rataflo/photocabine/doc/build log/IMG_20191106_195408.jpg

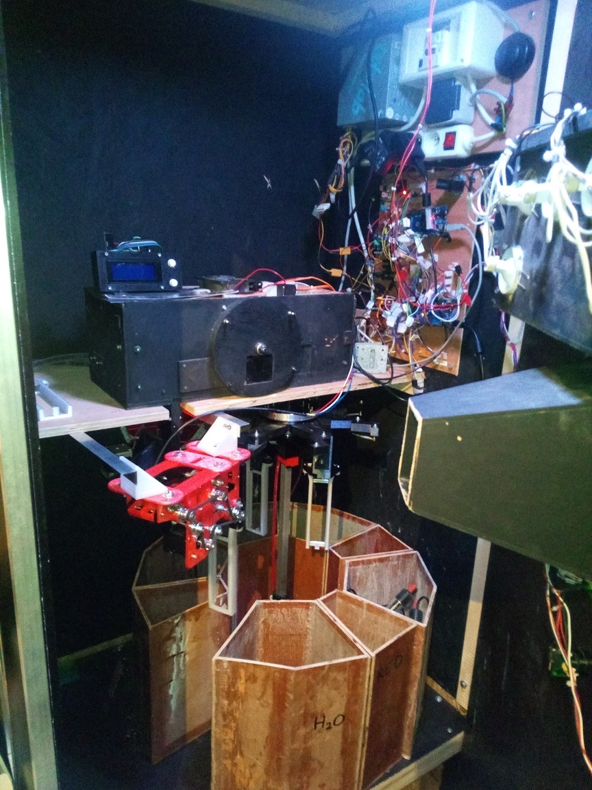
doc/build log/IMG_20191106_195408.jpg
