rataflo/photocabine/doc/Chemical_suppliers_usa.txt

Potassium dichromate : https://www.amazon.com/gp/offer-listing/B000B73OBO/ref=dp_olp_0?ie=UTF8&condition=all&qid=1568665300&sr=8-6
