rataflo/photocabine/hardware/easyeda_old/BOM_No_filter_booth_20200206081747.csv

ID | Name | Designator | Footprint | Quantity | Manufacturer Part | Manufacturer | Supplier | Supplier Part | Link | Price (USD)
1 | test2 | TEST |  | 1
2 | CYTRON MD10C | U-DRIVER_DC_ROTATION | MD10C | 1 | Cytron 13A, 5-30V Single DC Motor Controller |  |  | undefined
 |  |  | Total MD10C | 1
3 | led | LED_PAP2,LED_PAP3,LED__MIDDLE,LED_PAP4,LED_PAP1,LED__START,LED3_SHUTTER,LED_BOTTOM,LED,LED_ROT2,LED_UP,LED2_SCISSOR | 5MM_LED_2.54 | 12 | 5MMGREENLED |  | AliExpress |  | https://www.aliexpress.com/item/100Pcs-LED-5MM-RED-COLOR-RED-LIGHT-Super-Bright-Bulb-Lamp/32224565677.html | 0.01
 |  |  | Total 5MM_LED_2.54 | 12
4 | EXT_DIGITAL_CAMERA | EXT_DIGITAL_CAMERA | 1*10P_FEMALE | 1
 |  |  | Total 1*10P_FEMALE | 1
5 | ROT2 | SW_ROT2 | CONN-TH_3P-P2.00_KF2510_3A | 1 | kf2510_3A | BOOMELE | LCSC | C29275
6 | PAPER4 | SW_PAP4 | CONN-TH_3P-P2.00_KF2510_3A | 1 | kf2510_3A | BOOMELE | LCSC | C29275
7 | TEMP | BATH_TEMP | CONN-TH_3P-P2.00_KF2510_3A | 1 | kf2510_3A | BOOMELE | LCSC | C29275
8 | CEILING | CEILING | CONN-TH_3P-P2.00_KF2510_3A | 1 | kf2510_3A | BOOMELE | LCSC | C29275
9 | PAPER2 | SW_PAP2 | CONN-TH_3P-P2.00_KF2510_3A | 1 | kf2510_3A | BOOMELE | LCSC | C29275
10 | MARQUEE | MARQUEE | CONN-TH_3P-P2.00_KF2510_3A | 1 | kf2510_3A | BOOMELE | LCSC | C29275
11 | PAPER1 | SW_PAP1 | CONN-TH_3P-P2.00_KF2510_3A | 1 | kf2510_3A | BOOMELE | LCSC | C29275
12 | ROT1 | SW_ROT1 | CONN-TH_3P-P2.00_KF2510_3A | 1 | kf2510_3A | BOOMELE | LCSC | C29275
13 | PAPER3 | SW_PAP3 | CONN-TH_3P-P2.00_KF2510_3A | 1 | kf2510_3A | BOOMELE | LCSC | C29275
14 | SERVO | SERVO | CONN-TH_3P-P2.00_KF2510_3A | 1 | kf2510_3A | BOOMELE | LCSC | C29275
15 | LIGHT | PROCESS_LIGHT | CONN-TH_3P-P2.00_KF2510_3A | 1 | kf2510_3A | BOOMELE | LCSC | C29275
 |  |  | Total CONN-TH_3P-P2.00_KF2510_3A | 11
16 | RTC | RTC-DS3231-CONNECTOR | 5PIN DUPONT | 1
 |  |  | Total 5PIN DUPONT | 1
17 | ALIM_5V | ALIM_5V | D24V50F5 | 1
 |  |  | Total D24V50F5 | 1
18 | AUX | XT60_AUX | XT60 | 1
19 | FLASH | XT60-FLASH | XT60 | 1
20 | POWER_IN_12V | XT1_POWER_IN | XT60 | 1
 |  |  | Total XT60 | 3
21 | 100uF | 100UF_AUX,100UF_PROCESS_LIGHT,100UF_SERVO,C1_100UF_PAPER,C2_100UF_SHUTTER,C3_100UF_SCISSOR,C4_100UF_ROT,C5_100UF_EXIT | CPOL-RADIAL-100UF-25V | 8
22 | 100UF | 100UF_STARTBTN,100UF_FLASH,100UF_CEILING,100UF_MARQUEE | CPOL-RADIAL-100UF-25V | 4
 |  |  | Total CPOL-RADIAL-100UF-25V | 12
23 | UP | KF2_ENDSTOP_UP | CONN-TH_KF2510-2A | 1 | KF2510-2A | BOOMELE | LCSC | C27543
24 | DC_MOTOR | DC_MOTOR | CONN-TH_KF2510-2A | 1 | KF2510-2A | BOOMELE | LCSC | C27543
25 | BATT_PROBE | BATT_PROBE | CONN-TH_KF2510-2A | 1 | KF2510-2A | BOOMELE | LCSC | C27543
26 | SCISSOR | SW_SCISSOR | CONN-TH_KF2510-2A | 1 | KF2510-2A | BOOMELE | LCSC | C27543
27 | MIDDLE | KF2_ENDSTOP_MIDDLE | CONN-TH_KF2510-2A | 1 | KF2510-2A | BOOMELE | LCSC | C27543
28 | BOTTOM | KF2_ENDSTOP_DOWN | CONN-TH_KF2510-2A | 1 | KF2510-2A | BOOMELE | LCSC | C27543
29 | SHUTTER | SW_SHUTTER | CONN-TH_KF2510-2A | 1 | KF2510-2A | BOOMELE | LCSC | C27543
 |  |  | Total CONN-TH_KF2510-2A | 7
30 | 2.2K | R2_FLASH,R1_STARTBTN,R3_AUX | RES-2.3 | 3 | FHCFR-1/4W-222J |  | SeeedStudio | 301020010
 |  |  | Total RES-2.3 | 3
31 | TIP120 | TIP120_STARTBTN,TIP120_AUX | TO-220-3_L10.0-W4.5-P2.54-L | 2 | TIP120 | STMicroelectronics | LCSC | C262990
 |  |  | Total TO-220-3_L10.0-W4.5-P2.54-L | 2
32 | CAMERA | U1-CAMERA | MEGA2560 PRO-CH340G | 1 | MEGA2560 PRO-ch340G | RobotDyn | RobotDyn | MEGA2560 PRO-ch340G
33 | PAPER_PROCESS | U2-PAPER_PROCESS | MEGA2560 PRO-CH340G | 1 | MEGA2560 PRO-ch340G | RobotDyn | RobotDyn | MEGA2560 PRO-ch340G
 |  |  | Total MEGA2560 PRO-CH340G | 2
34 | SCISSOR | DRV_SCISSOR | POLOLU_BREAKOUT-16_15.2X20.3MM | 1
35 | ROTATION | DRV_ROT | POLOLU_BREAKOUT-16_15.2X20.3MM | 1 |  | Pololu
36 | PAPER | DRV_PAPER | POLOLU_BREAKOUT-16_15.2X20.3MM | 1 |  | Pololu
37 | SHUTTER | DRV_SHUTTER | POLOLU_BREAKOUT-16_15.2X20.3MM | 1
38 | EXIT | DRV_EXIT | POLOLU_BREAKOUT-16_15.2X20.3MM | 1 |  | Pololu
 |  |  | Total POLOLU_BREAKOUT-16_15.2X20.3MM | 5
39 | ANALOG_CAMERA | EXT_ANALOG_CAMERA | DUPONT_MALE_16X1_ARNOZ | 1 | 1.27mm1*10P Straight Headers Pins | ReliaPro | LCSC | C28952
40 | DIGITAL_PAPER | EXT_DIGITAL_PAPER | DUPONT_MALE_16X1_ARNOZ | 1 | 1.27mm1*10P Straight Headers Pins | ReliaPro | LCSC | C28952
41 | ANALOG_PAPER | EXT_ANALOG_PAPER | DUPONT_MALE_16X1_ARNOZ | 1 | 1.27mm1*10P Straight Headers Pins | ReliaPro | LCSC | C28952
 |  |  | Total DUPONT_MALE_16X1_ARNOZ | 3
42 | 20k | R1_20K_12VBATT | PKG-0.25W RESISTOR | 1 | CFR16J15K | MULTICOMP | Element14 | 2329483
43 | 10k | R2_10K_12VBATT | PKG-0.25W RESISTOR | 1 | CFR16J15K | MULTICOMP | Element14 | 2329483
 |  |  | Total PKG-0.25W RESISTOR | 2
44 | NRF24 | NRF24L01 | HEADER 4X2 | 1 | Custom
 |  |  | Total HEADER 4X2 | 1
45 | MATRIX | LEDMATRIX | KF2510-5A | 1 | KF2510-5A | ReliaPro | LCSC | C27544
 |  |  | Total KF2510-5A | 1
46 | RT-S01-145-L1NB1B | SW1 | SW-TH_RT-S01-145-L1NB1B | 1 | RT-S01-145-L1NB1B | ROCKTEK | LCSC | C312627
 |  |  | Total SW-TH_RT-S01-145-L1NB1B | 1
47 | ROTATION | KF2510-4A_ROT | CONN-TH_4P-P2.54_KF2510-4A | 1 | KF2510-4A | ReliaPro | LCSC | C27542
48 | SHUTTER | KF4_2_STEP_SHUTTER | CONN-TH_4P-P2.54_KF2510-4A | 1 | KF2510-4A | ReliaPro | LCSC | C27542
49 | KF2510-4A | EXIT | CONN-TH_4P-P2.54_KF2510-4A | 1 | KF2510-4A | ReliaPro | LCSC | C27542
50 | START | KF2510-4A-START_BTN | CONN-TH_4P-P2.54_KF2510-4A | 1 | KF2510-4A | ReliaPro | LCSC | C27542
51 | SEGMENT | SEGMENT | CONN-TH_4P-P2.54_KF2510-4A | 1 | KF2510-4A | ReliaPro | LCSC | C27542
52 | LUX_SENSOR | LUX_SENSOR | CONN-TH_4P-P2.54_KF2510-4A | 1 | KF2510-4A | ReliaPro | LCSC | C27542
53 | COIN | COIN | CONN-TH_4P-P2.54_KF2510-4A | 1 | KF2510-4A | ReliaPro | LCSC | C27542
54 | PAPER | KF4_3_STEP_PAPER | CONN-TH_4P-P2.54_KF2510-4A | 1 | KF2510-4A | ReliaPro | LCSC | C27542
55 | SCISSOR | STEP_SCISSOR | CONN-TH_4P-P2.54_KF2510-4A | 1 | KF2510-4A | ReliaPro | LCSC | C27542
 |  |  | Total CONN-TH_4P-P2.54_KF2510-4A | 9
56 | 150ohm | R1_UP,R5_SHUTTER,R3_MIDDLE,R_ROT1,R_PAP2,R2_BOTTOM,R_PAP3,R_ROT2,R_PAP4,R1_START,R_PAP1,R4_SCISSOR | ER_RESISTOR_150R/0.6_W | 12 |  |  |  | undefined
 |  |  | Total ER_RESISTOR_150R/0.6_W | 12
57 | 0.1uF | 100UF_MEGA_CAMERA,01UF_MEGA_PAPER,01UF_RTC,01UF_COIN,01UF_SEGMENT,01UF_MATRIX,01UF_MARQUEE | 100NF_CONDO | 7 | 0.1uF(104) 100V | ReliaPro | LCSC | undefined
 |  |  | Total 100NF_CONDO | 7
58 | BDX53B | BDX53B_FLASH | TO-220 | 1
 |  |  | Total TO-220 | 1
 |  |  | Total général | 99
