rataflo/photocabine/svg/lasercut1_bis.dxf

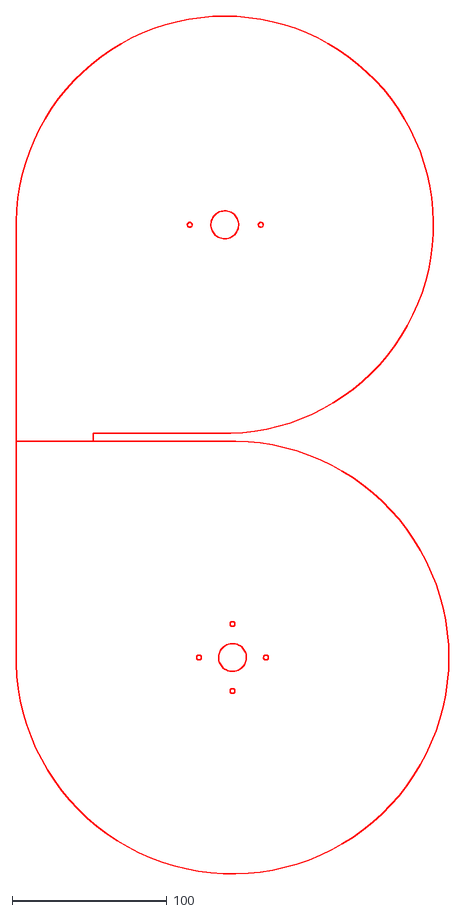
[picture p2: CAD file, 2020-11-24]
svg/lasercut1_bis.dxf
279.9 x 554.9
