rataflo/photocabine/svg/lasercut2_bis.dxf

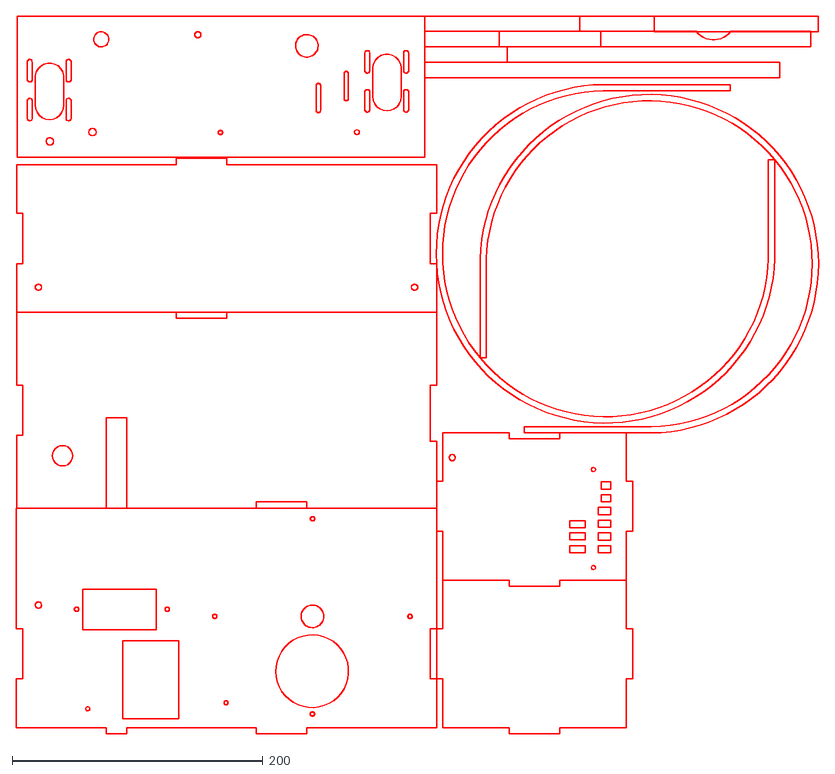
[picture p3: CAD file, 2020-11-24]
svg/lasercut2_bis.dxf
639.6 x 572.5
