rataflo/photocabine/svg/lasercut2.dxf

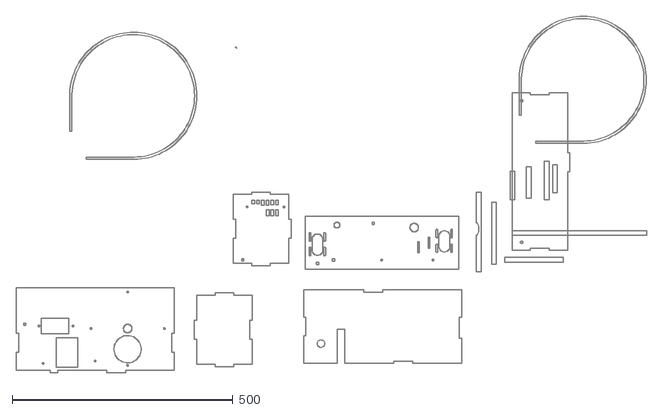
[picture p4: CAD file, 2020-11-24]
svg/lasercut2.dxf
1425.9 x 806.8
