rataflo/photocabine/(list of files, cad)

Other CAD files:
3dprint/dc_motor_support_xd-3420.skp
3dprint/paper_support_spider.skp
3dprint/support_6000Z.skp
