rataflo/photocabine/(list of files, drawings)

Other design files:
hardware/easyeda_old/1-PCB_PCB_2020-01-23 22_02_10.json
hardware/easyeda_old/1-Schematic_No filter booth pcb.json
hardware/easyeda_old/Schematic.schdoc
hardware/easyeda_old/SchematicV2.schdoc
hardware/kicad/nofilterbooth.dsn
