rataflo/photocabine/hardware/kicad/nofilterbooth.kicad_pcb

## KiCad design hardware/kicad/nofilterbooth.kicad_pcb (2020-02-25)

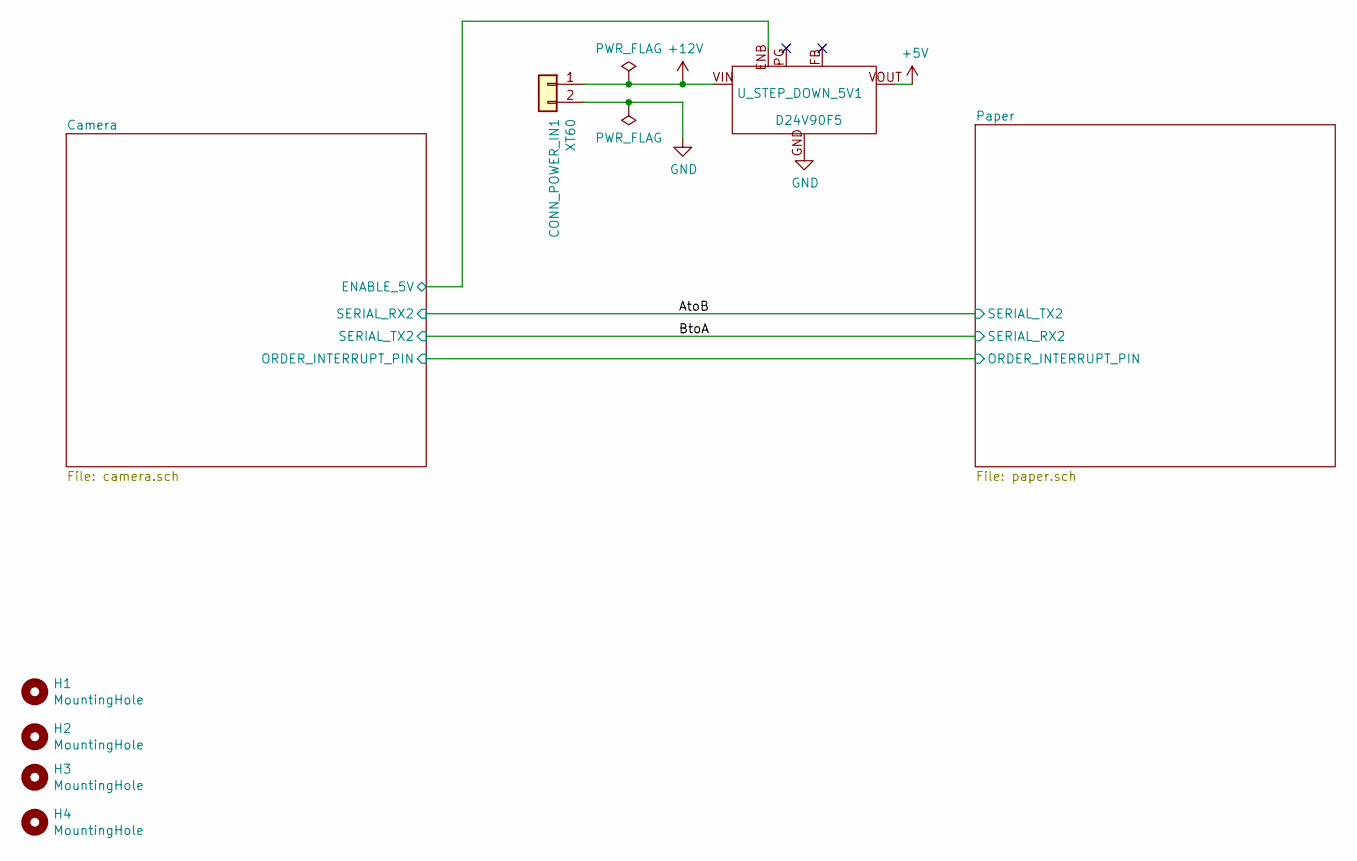
[picture p8: schematic nofilterbooth.sch]

Parts:
CONN_POWER_IN1: XT60; AMASS_XT60-F_1x02_P7.20mm_Vertical
H1, H2, H3, H4: MountingHole; MountingHole_3.2mm_M3
U_STEP_DOWN_5V1: D24V90F5

Connections:
+5V: U_STEP_DOWN_5V1.VOUT; also elsewhere on the board
+12V: CONN_POWER_IN1.1, U_STEP_DOWN_5V1.VIN; also elsewhere on the board
/Camera/ENABLE_5V: U_STEP_DOWN_5V1.ENB; also elsewhere on the board
GND: CONN_POWER_IN1.2, U_STEP_DOWN_5V1.GND; also elsewhere on the board

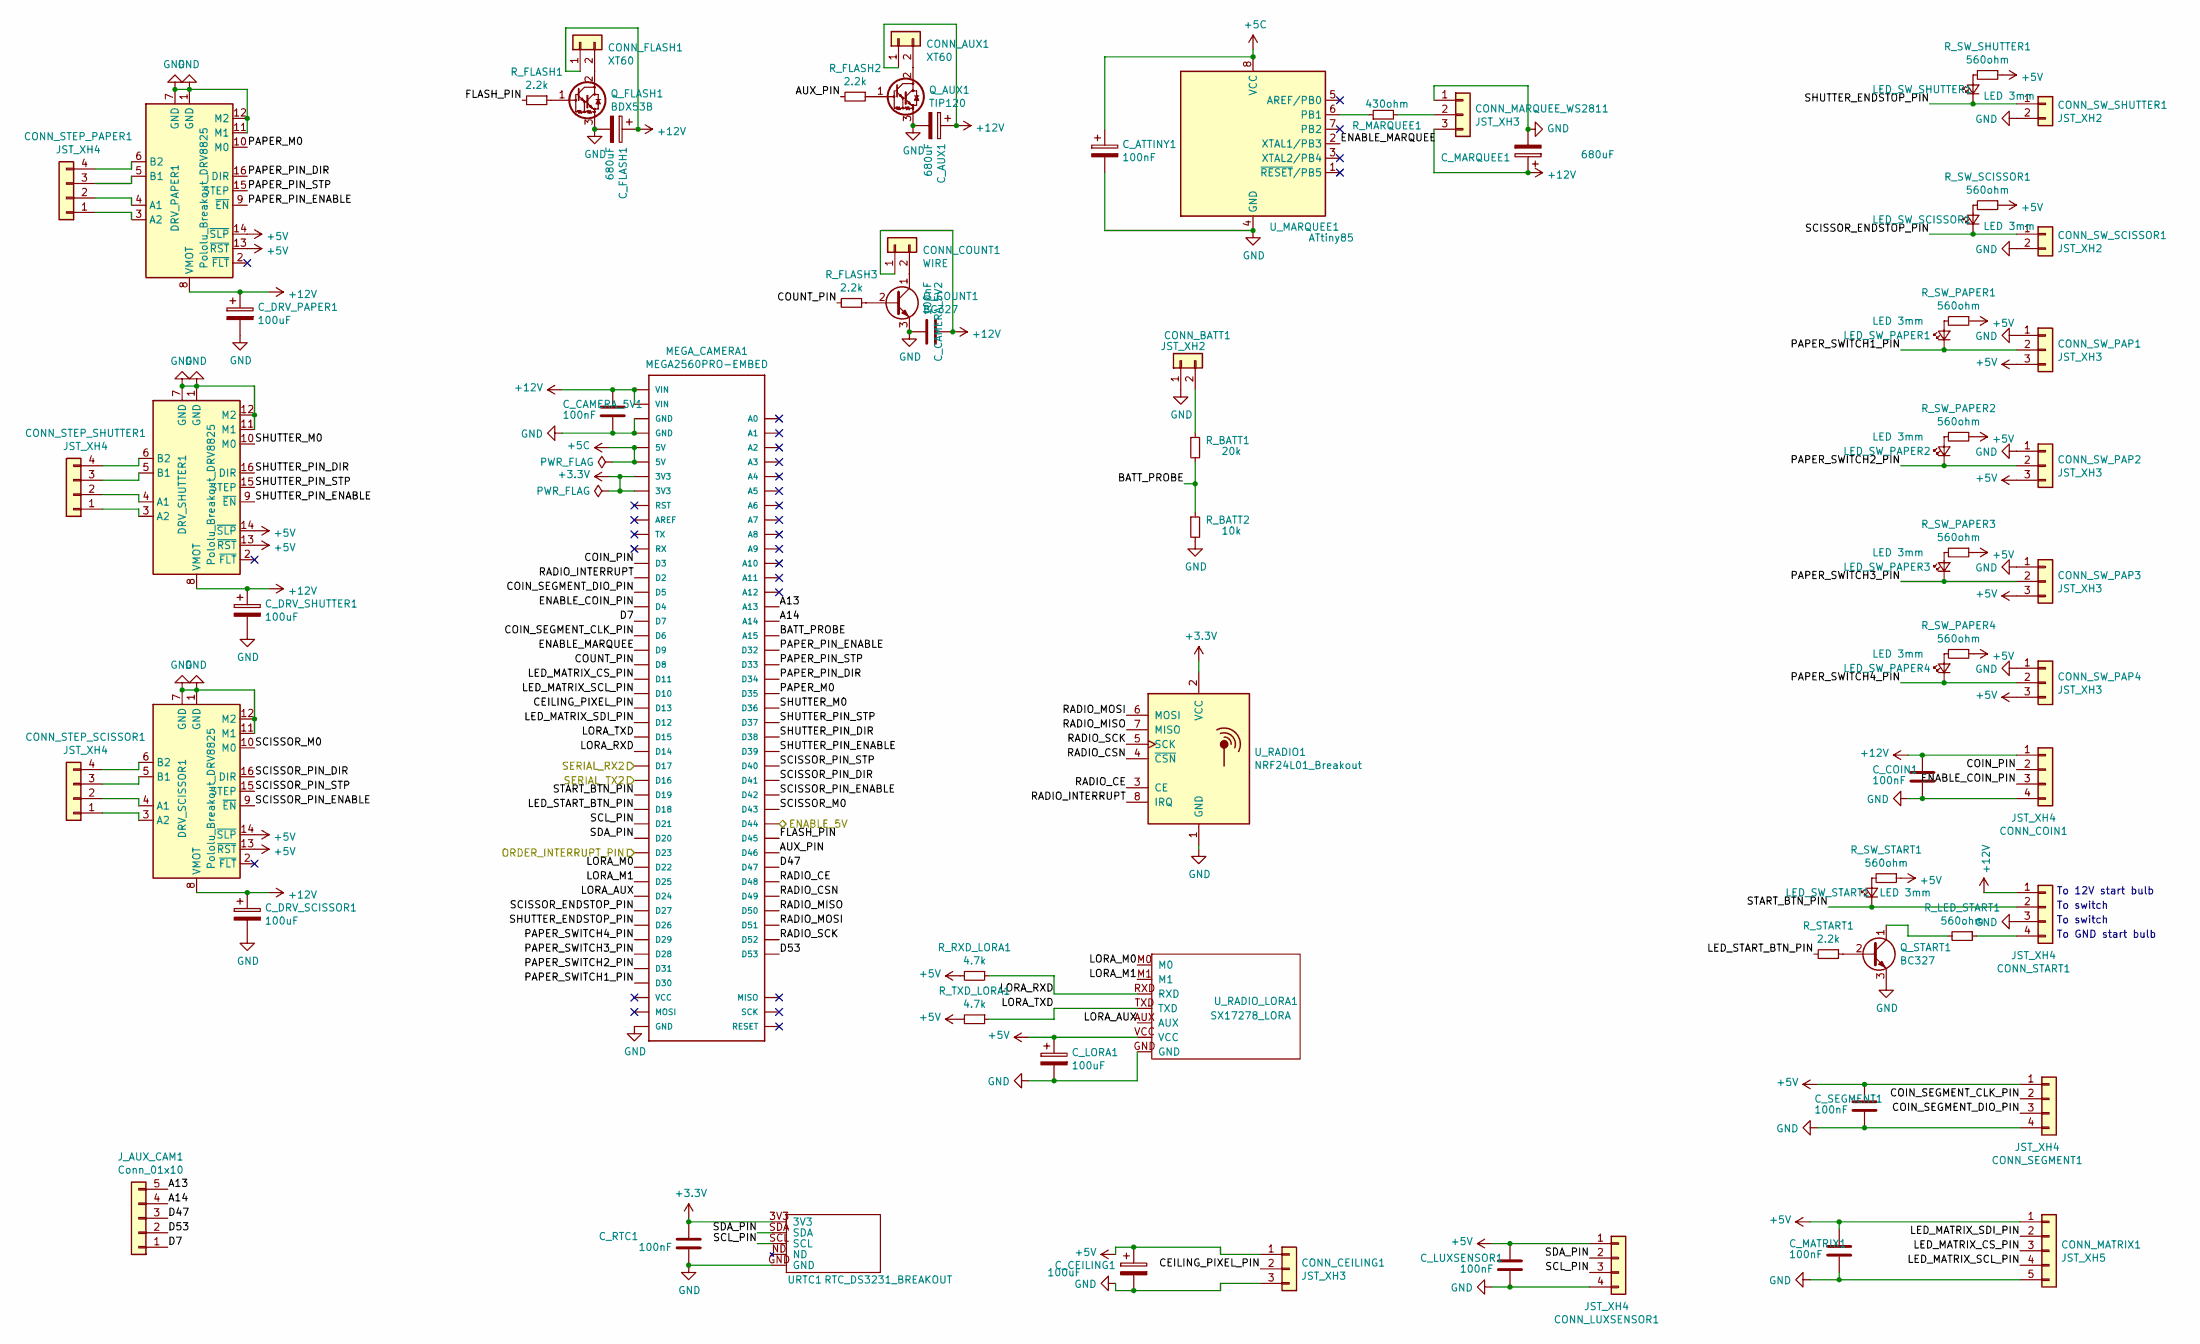
[picture p9: schematic camera.sch]

Parts:
CONN_AUX1: XT60; AMASS_XT60-F_1x02_P7.20mm_Vertical
CONN_BATT1: JST_XH2; JST_XH_S2B-XH-A-1_1x02_P2.50mm_Horizontal
CONN_CEILING1: JST_XH3; JST_XH_S3B-XH-A-1_1x03_P2.50mm_Horizontal
CONN_COIN1: JST_XH4; JST_XH_S4B-XH-A-1_1x04_P2.50mm_Horizontal
CONN_COUNT1: WIRE; PinHeader_1x02_P2.54mm_Vertical
CONN_FLASH1: XT60; AMASS_XT60-F_1x02_P7.20mm_Vertical
CONN_LUXSENSOR1: JST_XH4; JST_XH_S4B-XH-A-1_1x04_P2.50mm_Horizontal
CONN_MARQUEE_WS2811: JST_XH3; JST_XH_S3B-XH-A-1_1x03_P2.50mm_Horizontal
CONN_MATRIX1: JST_XH5; JST_XH_S5B-XH-A-1_1x05_P2.50mm_Horizontal
CONN_SEGMENT1: JST_XH4; JST_XH_S4B-XH-A-1_1x04_P2.50mm_Horizontal
CONN_START1: JST_XH4; JST_XH_S4B-XH-A-1_1x04_P2.50mm_Horizontal
CONN_STEP_PAPER1: JST_XH4; JST_XH_S4B-XH-A-1_1x04_P2.50mm_Horizontal
CONN_STEP_SCISSOR1: JST_XH4; JST_XH_S4B-XH-A-1_1x04_P2.50mm_Horizontal
CONN_STEP_SHUTTER1: JST_XH4; JST_XH_S4B-XH-A-1_1x04_P2.50mm_Horizontal
CONN_SW_PAP1, CONN_SW_PAP2, CONN_SW_PAP3, CONN_SW_PAP4: JST_XH3; JST_XH_S3B-XH-A-1_1x03_P2.50mm_Horizontal
CONN_SW_SCISSOR1: JST_XH2; JST_XH_S2B-XH-A-1_1x02_P2.50mm_Horizontal
CONN_SW_SHUTTER1: JST_XH2; JST_XH_S2B-XH-A-1_1x02_P2.50mm_Horizontal
C_ATTINY1: 100nF; C_Rect_L7.2mm_W2.5mm_P5.00mm_FKS2_FKP2_MKS2_MKP2
C_AUX1: 680uF; CP_Radial_D8.0mm_P3.50mm
C_CAMERA_5V1, C_CAMERA_5V2: 100nF; C_Rect_L7.2mm_W2.5mm_P5.00mm_FKS2_FKP2_MKS2_MKP2
C_CEILING1: 100uF; CP_Radial_D6.3mm_P2.50mm
C_COIN1: 100nF; C_Rect_L7.2mm_W2.5mm_P5.00mm_FKS2_FKP2_MKS2_MKP2
C_DRV_PAPER1: 100uF; CP_Radial_D6.3mm_P2.50mm
C_DRV_SCISSOR1: 100uF; CP_Radial_D6.3mm_P2.50mm
C_DRV_SHUTTER1: 100uF; CP_Radial_D6.3mm_P2.50mm
C_FLASH1: 680uF; CP_Radial_D8.0mm_P3.50mm
C_LORA1: 100uF; CP_Radial_D6.3mm_P2.50mm
C_LUXSENSOR1: 100nF; C_Rect_L7.2mm_W2.5mm_P5.00mm_FKS2_FKP2_MKS2_MKP2
C_MARQUEE1: 680uF; CP_Radial_D8.0mm_P3.50mm
C_MATRIX1: 100nF; C_Rect_L7.2mm_W2.5mm_P5.00mm_FKS2_FKP2_MKS2_MKP2
C_RTC1: 100nF; C_Rect_L7.2mm_W2.5mm_P5.00mm_FKS2_FKP2_MKS2_MKP2
C_SEGMENT1: 100nF; C_Rect_L7.2mm_W2.5mm_P5.00mm_FKS2_FKP2_MKS2_MKP2
DRV_PAPER1: Pololu_Breakout_DRV8825; Pololu_Breakout-16_15.2x20.3mm
DRV_SCISSOR1: Pololu_Breakout_DRV8825; Pololu_Breakout-16_15.2x20.3mm
DRV_SHUTTER1: Pololu_Breakout_DRV8825; Pololu_Breakout-16_15.2x20.3mm
J_AUX_CAM1: Conn_01x10; PinHeader_1x05_P2.54mm_Vertical
LED_SW_PAPER1, LED_SW_PAPER2, LED_SW_PAPER3, LED_SW_PAPER4: LED 3mm; LED_D3.0mm
LED_SW_SCISSOR1: LED 3mm; LED_D3.0mm
LED_SW_SHUTTER1: LED 3mm; LED_D3.0mm
LED_SW_START1: LED 3mm; LED_D3.0mm
MEGA_CAMERA1: MEGA2560PRO-EMBED
Q_AUX1: TIP120; TO-220-3_Vertical
Q_COUNT1: BC327; TO-92L_HandSolder
Q_FLASH1: BDX53B; TO-220-3_Vertical
Q_START1: BC327; TO-92L_HandSolder
R_BATT1: 20k; R_Axial_DIN0207_L6.3mm_D2.5mm_P10.16mm_Horizontal
R_BATT2: 10k; R_Axial_DIN0207_L6.3mm_D2.5mm_P10.16mm_Horizontal
R_FLASH1, R_FLASH2, R_FLASH3: 2.2k; R_Axial_DIN0207_L6.3mm_D2.5mm_P10.16mm_Horizontal
R_LED_START1: 560ohm; R_Axial_DIN0207_L6.3mm_D2.5mm_P10.16mm_Horizontal
R_MARQUEE1: 430ohm; R_Axial_DIN0207_L6.3mm_D2.5mm_P10.16mm_Horizontal
R_RXD_LORA1: 4.7k; R_Axial_DIN0207_L6.3mm_D2.5mm_P10.16mm_Horizontal
R_START1: 2.2k; R_Axial_DIN0207_L6.3mm_D2.5mm_P10.16mm_Horizontal
R_SW_PAPER1, R_SW_PAPER2, R_SW_PAPER3, R_SW_PAPER4: 560ohm; R_Axial_DIN0207_L6.3mm_D2.5mm_P10.16mm_Horizontal
R_SW_SCISSOR1: 560ohm; R_Axial_DIN0207_L6.3mm_D2.5mm_P10.16mm_Horizontal
R_SW_SHUTTER1: 560ohm; R_Axial_DIN0207_L6.3mm_D2.5mm_P10.16mm_Horizontal
R_SW_START1: 560ohm; R_Axial_DIN0207_L6.3mm_D2.5mm_P10.16mm_Horizontal
R_TXD_LORA1: 4.7k; R_Axial_DIN0207_L6.3mm_D2.5mm_P10.16mm_Horizontal
URTC1: RTC_DS3231_BREAKOUT; DS3231_breakout
U_MARQUEE1: ATtiny85; DIP-8_W7.62mm
U_RADIO1: NRF24L01_Breakout; nRF24L01_Breakout
U_RADIO_LORA1: SX17278_LORA; LORA_E32-TTL-100

Connections:
+3V3: C_RTC1.1, MEGA_CAMERA1.3V3, URTC1.3V3, U_RADIO1.2 (VCC)
+5C: C_ATTINY1.1, MEGA_CAMERA1.5V, U_MARQUEE1.8 (VCC)
+5V: CONN_CEILING1.1, CONN_LUXSENSOR1.1, CONN_MATRIX1.1, CONN_SEGMENT1.1, CONN_SW_PAP1.3, CONN_SW_PAP2.3, CONN_SW_PAP3.3, CONN_SW_PAP4.3, C_CEILING1.1, C_LORA1.1, C_LUXSENSOR1.1, C_MATRIX1.1, C_SEGMENT1.1, DRV_PAPER1.13 (~RST), DRV_PAPER1.14 (~SLP), DRV_SCISSOR1.13 (~RST), DRV_SCISSOR1.14 (~SLP), DRV_SHUTTER1.13 (~RST), DRV_SHUTTER1.14 (~SLP), R_RXD_LORA1.2, R_SW_PAPER1.1, R_SW_PAPER2.1, R_SW_PAPER3.1, R_SW_PAPER4.1, R_SW_SCISSOR1.1, R_SW_SHUTTER1.1, R_SW_START1.1, R_TXD_LORA1.2, U_RADIO_LORA1.VCC; also elsewhere on the board
+12V: CONN_AUX1.1, CONN_COIN1.1, CONN_COUNT1.1, CONN_FLASH1.1, CONN_MARQUEE_WS2811.3, CONN_START1.1, C_AUX1.1, C_CAMERA_5V1.1, C_CAMERA_5V2.1, C_COIN1.1, C_DRV_PAPER1.1, C_DRV_SCISSOR1.1, C_DRV_SHUTTER1.1, C_FLASH1.1, C_MARQUEE1.1, DRV_PAPER1.8 (VMOT), DRV_SCISSOR1.8 (VMOT), DRV_SHUTTER1.8 (VMOT), MEGA_CAMERA1.VIN; also elsewhere on the board
/AtoB: MEGA_CAMERA1.D17; also elsewhere on the board
/BtoA: MEGA_CAMERA1.D16; also elsewhere on the board
/Camera/A13: J_AUX_CAM1.5, MEGA_CAMERA1.A13
/Camera/A14: J_AUX_CAM1.4, MEGA_CAMERA1.A14
/Camera/AUX_PIN: MEGA_CAMERA1.D46, R_FLASH2.2
/Camera/BATT_PROBE: MEGA_CAMERA1.A15, R_BATT1.2, R_BATT2.1
/Camera/CEILING_PIXEL_PIN: CONN_CEILING1.2, MEGA_CAMERA1.D13
/Camera/COIN_PIN: CONN_COIN1.2, MEGA_CAMERA1.D3
/Camera/COIN_SEGMENT_CLK_PIN: CONN_SEGMENT1.2, MEGA_CAMERA1.D6
/Camera/COIN_SEGMENT_DIO_PIN: CONN_SEGMENT1.3, MEGA_CAMERA1.D5
/Camera/COUNT_PIN: MEGA_CAMERA1.D8, R_FLASH3.2
/Camera/D7: J_AUX_CAM1.1, MEGA_CAMERA1.D7
/Camera/D47: J_AUX_CAM1.3, MEGA_CAMERA1.D47
/Camera/D53: J_AUX_CAM1.2, MEGA_CAMERA1.D53
/Camera/ENABLE_5V: MEGA_CAMERA1.D44; also elsewhere on the board
/Camera/ENABLE_COIN_PIN: CONN_COIN1.3, MEGA_CAMERA1.D4
/Camera/ENABLE_MARQUEE: MEGA_CAMERA1.D9, U_MARQUEE1.2 (XTAL1/PB3)
/Camera/FLASH_PIN: MEGA_CAMERA1.D45, R_FLASH1.2
/Camera/LED_MATRIX_CS_PIN: CONN_MATRIX1.3, MEGA_CAMERA1.D11
/Camera/LED_MATRIX_SCL_PIN: CONN_MATRIX1.4, MEGA_CAMERA1.D10
/Camera/LED_MATRIX_SDI_PIN: CONN_MATRIX1.2, MEGA_CAMERA1.D12
/Camera/LED_START_BTN_PIN: MEGA_CAMERA1.D18, R_START1.2
/Camera/LORA_AUX: MEGA_CAMERA1.D24, U_RADIO_LORA1.AUX
/Camera/LORA_M0: MEGA_CAMERA1.D22, U_RADIO_LORA1.M0
/Camera/LORA_M1: MEGA_CAMERA1.D25, U_RADIO_LORA1.M1
/Camera/LORA_RXD: MEGA_CAMERA1.D14, R_RXD_LORA1.1, U_RADIO_LORA1.RXD
/Camera/LORA_TXD: MEGA_CAMERA1.D15, R_TXD_LORA1.1, U_RADIO_LORA1.TXD
/Camera/ORDER_INTERRUPT_PIN: MEGA_CAMERA1.D23; also elsewhere on the board
/Camera/PAPER_M0: DRV_PAPER1.10 (M0), MEGA_CAMERA1.D35
/Camera/PAPER_PIN_DIR: DRV_PAPER1.16 (DIR), MEGA_CAMERA1.D34
/Camera/PAPER_PIN_ENABLE: DRV_PAPER1.9 (~EN), MEGA_CAMERA1.D32
/Camera/PAPER_PIN_STP: DRV_PAPER1.15 (STEP), MEGA_CAMERA1.D33
/Camera/PAPER_SWITCH1_PIN: CONN_SW_PAP1.2, LED_SW_PAPER1.1 (K), MEGA_CAMERA1.D30
/Camera/PAPER_SWITCH2_PIN: CONN_SW_PAP2.2, LED_SW_PAPER2.1 (K), MEGA_CAMERA1.D31
/Camera/PAPER_SWITCH3_PIN: CONN_SW_PAP3.2, LED_SW_PAPER3.1 (K), MEGA_CAMERA1.D28
/Camera/PAPER_SWITCH4_PIN: CONN_SW_PAP4.2, LED_SW_PAPER4.1 (K), MEGA_CAMERA1.D29
/Camera/RADIO_CE: MEGA_CAMERA1.D48, U_RADIO1.3 (CE)
/Camera/RADIO_CSN: MEGA_CAMERA1.D49, U_RADIO1.4 (~CSN)
/Camera/RADIO_INTERRUPT: MEGA_CAMERA1.D2, U_RADIO1.8 (IRQ)
/Camera/RADIO_MISO: MEGA_CAMERA1.D50, U_RADIO1.7 (MISO)
/Camera/RADIO_MOSI: MEGA_CAMERA1.D51, U_RADIO1.6 (MOSI)
/Camera/RADIO_SCK: MEGA_CAMERA1.D52, U_RADIO1.5 (SCK)
/Camera/SCISSOR_ENDSTOP_PIN: CONN_SW_SCISSOR1.1, LED_SW_SCISSOR1.1 (K), MEGA_CAMERA1.D27
/Camera/SCISSOR_M0: DRV_SCISSOR1.10 (M0), MEGA_CAMERA1.D43
/Camera/SCISSOR_PIN_DIR: DRV_SCISSOR1.16 (DIR), MEGA_CAMERA1.D41
/Camera/SCISSOR_PIN_ENABLE: DRV_SCISSOR1.9 (~EN), MEGA_CAMERA1.D42
/Camera/SCISSOR_PIN_STP: DRV_SCISSOR1.15 (STEP), MEGA_CAMERA1.D40
/Camera/SCL_PIN: CONN_LUXSENSOR1.3, MEGA_CAMERA1.D21, URTC1.SCL
/Camera/SDA_PIN: CONN_LUXSENSOR1.2, MEGA_CAMERA1.D20, URTC1.SDA
/Camera/SHUTTER_ENDSTOP_PIN: CONN_SW_SHUTTER1.1, LED_SW_SHUTTER1.1 (K), MEGA_CAMERA1.D26
/Camera/SHUTTER_M0: DRV_SHUTTER1.10 (M0), MEGA_CAMERA1.D36
/Camera/SHUTTER_PIN_DIR: DRV_SHUTTER1.16 (DIR), MEGA_CAMERA1.D38
/Camera/SHUTTER_PIN_ENABLE: DRV_SHUTTER1.9 (~EN), MEGA_CAMERA1.D39
/Camera/SHUTTER_PIN_STP: DRV_SHUTTER1.15 (STEP), MEGA_CAMERA1.D37
/Camera/START_BTN_PIN: CONN_START1.2, LED_SW_START1.1 (K), MEGA_CAMERA1.D19
GND: CONN_BATT1.1, CONN_CEILING1.3, CONN_COIN1.4, CONN_LUXSENSOR1.4, CONN_MARQUEE_WS2811.1, CONN_MATRIX1.5, CONN_SEGMENT1.4, CONN_START1.3, CONN_SW_PAP1.1, CONN_SW_PAP2.1, CONN_SW_PAP3.1, CONN_SW_PAP4.1, CONN_SW_SCISSOR1.2, CONN_SW_SHUTTER1.2, C_ATTINY1.2, C_AUX1.2, C_CAMERA_5V1.2, C_CAMERA_5V2.2, C_CEILING1.2, C_COIN1.2, C_DRV_PAPER1.2, C_DRV_SCISSOR1.2, C_DRV_SHUTTER1.2, C_FLASH1.2, C_LORA1.2, C_LUXSENSOR1.2, C_MARQUEE1.2, C_MATRIX1.2, C_RTC1.2, C_SEGMENT1.2, DRV_PAPER1.1 (GND), DRV_PAPER1.7 (GND), DRV_PAPER1.11 (M1), DRV_PAPER1.12 (M2), DRV_SCISSOR1.1 (GND), DRV_SCISSOR1.7 (GND), DRV_SCISSOR1.11 (M1), DRV_SCISSOR1.12 (M2), DRV_SHUTTER1.1 (GND), DRV_SHUTTER1.7 (GND), DRV_SHUTTER1.11 (M1), DRV_SHUTTER1.12 (M2), MEGA_CAMERA1.GND, Q_AUX1.3 (E), Q_COUNT1.3 (E), Q_FLASH1.3 (E), Q_START1.3 (E), R_BATT2.2, URTC1.GND, U_MARQUEE1.4 (GND), U_RADIO1.1 (GND), U_RADIO_LORA1.GND; also elsewhere on the board
unnamed: CONN_AUX1.2, Q_AUX1.2 (C)
unnamed: CONN_BATT1.2, R_BATT1.1
unnamed: CONN_COUNT1.2, Q_COUNT1.1 (C)
unnamed: CONN_FLASH1.2, Q_FLASH1.2 (C)
unnamed: CONN_MARQUEE_WS2811.2, R_MARQUEE1.2
unnamed: CONN_START1.4, R_LED_START1.1
unnamed: CONN_STEP_PAPER1.1, DRV_PAPER1.3 (A2)
unnamed: CONN_STEP_PAPER1.2, DRV_PAPER1.4 (A1)
unnamed: CONN_STEP_PAPER1.3, DRV_PAPER1.5 (B1)
unnamed: CONN_STEP_PAPER1.4, DRV_PAPER1.6 (B2)
unnamed: CONN_STEP_SCISSOR1.1, DRV_SCISSOR1.3 (A2)
unnamed: CONN_STEP_SCISSOR1.2, DRV_SCISSOR1.4 (A1)
unnamed: CONN_STEP_SCISSOR1.3, DRV_SCISSOR1.5 (B1)
unnamed: CONN_STEP_SCISSOR1.4, DRV_SCISSOR1.6 (B2)
unnamed: CONN_STEP_SHUTTER1.1, DRV_SHUTTER1.3 (A2)
unnamed: CONN_STEP_SHUTTER1.2, DRV_SHUTTER1.4 (A1)
unnamed: CONN_STEP_SHUTTER1.3, DRV_SHUTTER1.5 (B1)
unnamed: CONN_STEP_SHUTTER1.4, DRV_SHUTTER1.6 (B2)
unnamed: LED_SW_PAPER1.2 (A), R_SW_PAPER1.2
unnamed: LED_SW_PAPER2.2 (A), R_SW_PAPER2.2
unnamed: LED_SW_PAPER3.2 (A), R_SW_PAPER3.2
unnamed: LED_SW_PAPER4.2 (A), R_SW_PAPER4.2
unnamed: LED_SW_SCISSOR1.2 (A), R_SW_SCISSOR1.2
unnamed: LED_SW_SHUTTER1.2 (A), R_SW_SHUTTER1.2
unnamed: LED_SW_START1.2 (A), R_SW_START1.2
unnamed: Q_AUX1.1 (B), R_FLASH2.1
unnamed: Q_COUNT1.2 (B), R_FLASH3.1
unnamed: Q_FLASH1.1 (B), R_FLASH1.1
unnamed: Q_START1.1 (C), R_LED_START1.2
unnamed: Q_START1.2 (B), R_START1.1
unnamed: R_MARQUEE1.1, U_MARQUEE1.6 (PB1)

Notes on the sheet:
To GND start bulb
To 12V start bulb
To switch

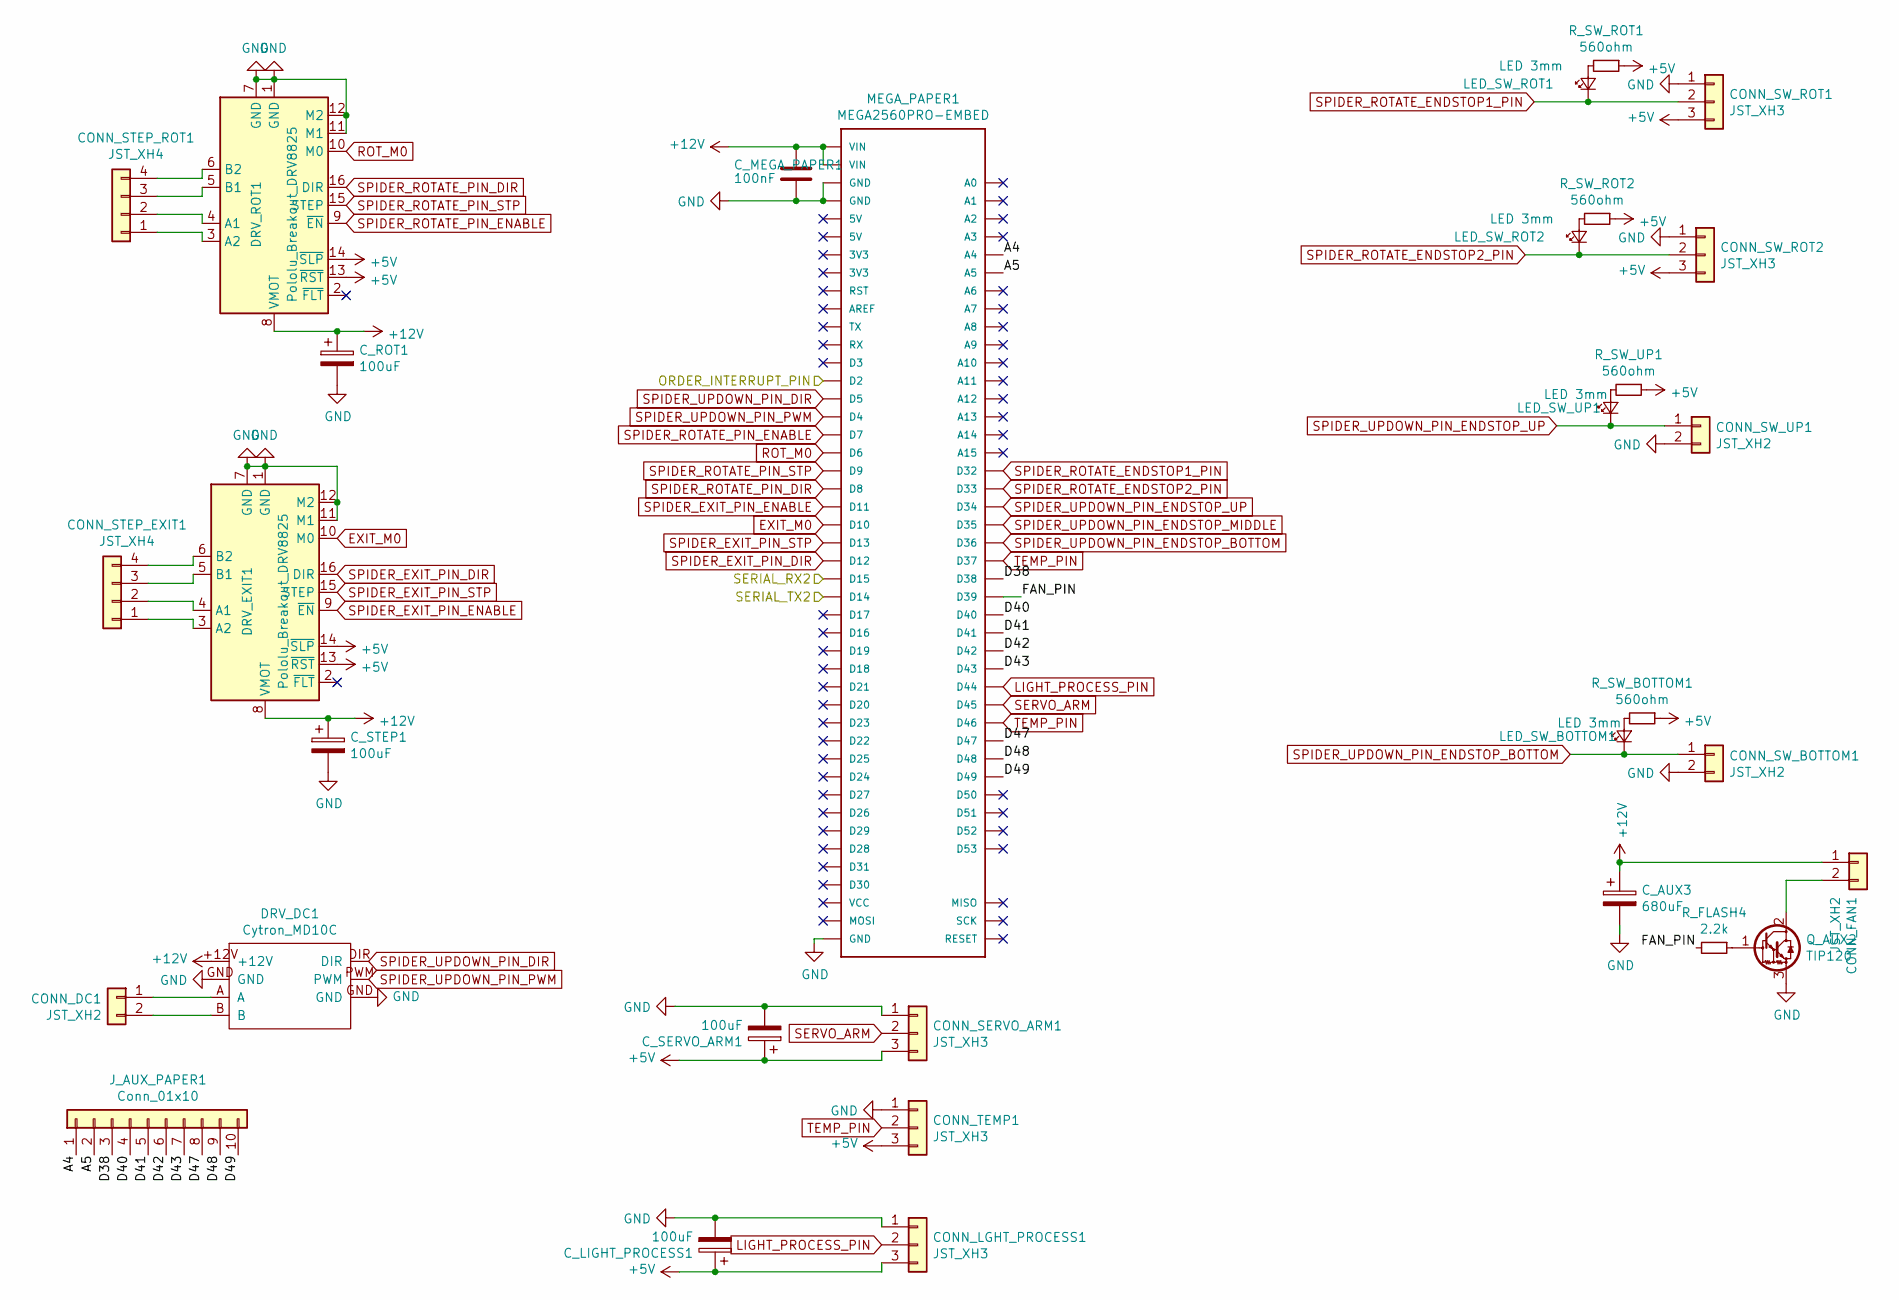
[picture p10: schematic paper.sch]

Parts:
CONN_DC1: JST_XH2; JST_XH_S2B-XH-A-1_1x02_P2.50mm_Horizontal
CONN_FAN1: JST_XH2; JST_XH_S2B-XH-A-1_1x02_P2.50mm_Horizontal
CONN_LGHT_PROCESS1: JST_XH3; JST_XH_S3B-XH-A-1_1x03_P2.50mm_Horizontal
CONN_SERVO_ARM1: JST_XH3; JST_XH_S3B-XH-A-1_1x03_P2.50mm_Horizontal
CONN_STEP_EXIT1: JST_XH4; JST_XH_S4B-XH-A-1_1x04_P2.50mm_Horizontal
CONN_STEP_ROT1: JST_XH4; JST_XH_S4B-XH-A-1_1x04_P2.50mm_Horizontal
CONN_SW_BOTTOM1: JST_XH2; JST_XH_S2B-XH-A-1_1x02_P2.50mm_Horizontal
CONN_SW_ROT1, CONN_SW_ROT2: JST_XH3; JST_XH_S3B-XH-A-1_1x03_P2.50mm_Horizontal
CONN_SW_UP1: JST_XH2; JST_XH_S2B-XH-A-1_1x02_P2.50mm_Horizontal
CONN_TEMP1: JST_XH3; JST_XH_S3B-XH-A-1_1x03_P2.50mm_Horizontal
C_AUX3: 680uF; CP_Radial_D8.0mm_P3.50mm
C_LIGHT_PROCESS1: 100uF; CP_Radial_D6.3mm_P2.50mm
C_MEGA_PAPER1: 100nF; C_Rect_L7.2mm_W2.5mm_P5.00mm_FKS2_FKP2_MKS2_MKP2
C_ROT1: 100uF; CP_Radial_D6.3mm_P2.50mm
C_SERVO_ARM1: 100uF; CP_Radial_D6.3mm_P2.50mm
C_STEP1: 100uF; CP_Radial_D6.3mm_P2.50mm
DRV_DC1: Cytron_MD10C; CYTRON_MD10C
DRV_EXIT1: Pololu_Breakout_DRV8825; Pololu_Breakout-16_15.2x20.3mm
DRV_ROT1: Pololu_Breakout_DRV8825; Pololu_Breakout-16_15.2x20.3mm
J_AUX_PAPER1: Conn_01x10; PinHeader_1x10_P2.54mm_Vertical
LED_SW_BOTTOM1: LED 3mm; LED_D3.0mm
LED_SW_ROT1, LED_SW_ROT2: LED 3mm; LED_D3.0mm
LED_SW_UP1: LED 3mm; LED_D3.0mm
MEGA_PAPER1: MEGA2560PRO-EMBED
Q_AUX2: TIP120; TO-220-3_Vertical
R_FLASH4: 2.2k; R_Axial_DIN0207_L6.3mm_D2.5mm_P10.16mm_Horizontal
R_SW_BOTTOM1: 560ohm; R_Axial_DIN0207_L6.3mm_D2.5mm_P10.16mm_Horizontal
R_SW_ROT1, R_SW_ROT2: 560ohm; R_Axial_DIN0207_L6.3mm_D2.5mm_P10.16mm_Horizontal
R_SW_UP1: 560ohm; R_Axial_DIN0207_L6.3mm_D2.5mm_P10.16mm_Horizontal

Connections:
+5V: CONN_LGHT_PROCESS1.3, CONN_SERVO_ARM1.3, CONN_SW_ROT1.3, CONN_SW_ROT2.3, CONN_TEMP1.3, C_LIGHT_PROCESS1.1, C_SERVO_ARM1.1, DRV_EXIT1.13 (~RST), DRV_EXIT1.14 (~SLP), DRV_ROT1.13 (~RST), DRV_ROT1.14 (~SLP), R_SW_BOTTOM1.1, R_SW_ROT1.1, R_SW_ROT2.1, R_SW_UP1.1; also elsewhere on the board
+12V: CONN_FAN1.1, C_AUX3.1, C_MEGA_PAPER1.1, C_ROT1.1, C_STEP1.1, DRV_DC1.+12V, DRV_EXIT1.8 (VMOT), DRV_ROT1.8 (VMOT), MEGA_PAPER1.VIN; also elsewhere on the board
/AtoB: MEGA_PAPER1.D14; also elsewhere on the board
/BtoA: MEGA_PAPER1.D15; also elsewhere on the board
/Camera/ORDER_INTERRUPT_PIN: MEGA_PAPER1.D2; also elsewhere on the board
/Paper/A4: J_AUX_PAPER1.1, MEGA_PAPER1.A4
/Paper/A5: J_AUX_PAPER1.2, MEGA_PAPER1.A5
/Paper/D38: J_AUX_PAPER1.3, MEGA_PAPER1.D38
/Paper/D40: J_AUX_PAPER1.4, MEGA_PAPER1.D40
/Paper/D41: J_AUX_PAPER1.5, MEGA_PAPER1.D41
/Paper/D42: J_AUX_PAPER1.6, MEGA_PAPER1.D42
/Paper/D43: J_AUX_PAPER1.7, MEGA_PAPER1.D43
/Paper/D47: J_AUX_PAPER1.8, MEGA_PAPER1.D47
/Paper/D48: J_AUX_PAPER1.9, MEGA_PAPER1.D48
/Paper/D49: J_AUX_PAPER1.10, MEGA_PAPER1.D49
/Paper/FAN_PIN: MEGA_PAPER1.D39, R_FLASH4.2
EXIT_M0: DRV_EXIT1.10 (M0), MEGA_PAPER1.D10
GND: CONN_LGHT_PROCESS1.1, CONN_SERVO_ARM1.1, CONN_SW_BOTTOM1.2, CONN_SW_ROT1.1, CONN_SW_ROT2.1, CONN_SW_UP1.2, CONN_TEMP1.1, C_AUX3.2, C_LIGHT_PROCESS1.2, C_MEGA_PAPER1.2, C_ROT1.2, C_SERVO_ARM1.2, C_STEP1.2, DRV_DC1.GND, DRV_EXIT1.1 (GND), DRV_EXIT1.7 (GND), DRV_EXIT1.11 (M1), DRV_EXIT1.12 (M2), DRV_ROT1.1 (GND), DRV_ROT1.7 (GND), DRV_ROT1.11 (M1), DRV_ROT1.12 (M2), MEGA_PAPER1.GND, Q_AUX2.3 (E); also elsewhere on the board
LIGHT_PROCESS_PIN: CONN_LGHT_PROCESS1.2, MEGA_PAPER1.D44
unnamed: CONN_DC1.1, DRV_DC1.A
unnamed: CONN_DC1.2, DRV_DC1.B
unnamed: CONN_FAN1.2, Q_AUX2.2 (C)
unnamed: CONN_STEP_EXIT1.1, DRV_EXIT1.3 (A2)
unnamed: CONN_STEP_EXIT1.2, DRV_EXIT1.4 (A1)
unnamed: CONN_STEP_EXIT1.3, DRV_EXIT1.5 (B1)
unnamed: CONN_STEP_EXIT1.4, DRV_EXIT1.6 (B2)
unnamed: CONN_STEP_ROT1.1, DRV_ROT1.3 (A2)
unnamed: CONN_STEP_ROT1.2, DRV_ROT1.4 (A1)
unnamed: CONN_STEP_ROT1.3, DRV_ROT1.5 (B1)
unnamed: CONN_STEP_ROT1.4, DRV_ROT1.6 (B2)
unnamed: LED_SW_BOTTOM1.2 (A), R_SW_BOTTOM1.2
unnamed: LED_SW_ROT1.2 (A), R_SW_ROT1.2
unnamed: LED_SW_ROT2.2 (A), R_SW_ROT2.2
unnamed: LED_SW_UP1.2 (A), R_SW_UP1.2
unnamed: Q_AUX2.1 (B), R_FLASH4.1
ROT_M0: DRV_ROT1.10 (M0), MEGA_PAPER1.D6
SERVO_ARM: CONN_SERVO_ARM1.2, MEGA_PAPER1.D45
SPIDER_EXIT_PIN_DIR: DRV_EXIT1.16 (DIR), MEGA_PAPER1.D12
SPIDER_EXIT_PIN_ENABLE: DRV_EXIT1.9 (~EN), MEGA_PAPER1.D11
SPIDER_EXIT_PIN_STP: DRV_EXIT1.15 (STEP), MEGA_PAPER1.D13
SPIDER_ROTATE_ENDSTOP1_PIN: CONN_SW_ROT1.2, LED_SW_ROT1.1 (K), MEGA_PAPER1.D32
SPIDER_ROTATE_ENDSTOP2_PIN: CONN_SW_ROT2.2, LED_SW_ROT2.1 (K), MEGA_PAPER1.D33
SPIDER_ROTATE_PIN_DIR: DRV_ROT1.16 (DIR), MEGA_PAPER1.D8
SPIDER_ROTATE_PIN_ENABLE: DRV_ROT1.9 (~EN), MEGA_PAPER1.D7
SPIDER_ROTATE_PIN_STP: DRV_ROT1.15 (STEP), MEGA_PAPER1.D9
SPIDER_UPDOWN_PIN_DIR: DRV_DC1.DIR, MEGA_PAPER1.D5
SPIDER_UPDOWN_PIN_ENDSTOP_BOTTOM: CONN_SW_BOTTOM1.1, LED_SW_BOTTOM1.1 (K), MEGA_PAPER1.D36
SPIDER_UPDOWN_PIN_ENDSTOP_UP: CONN_SW_UP1.1, LED_SW_UP1.1 (K), MEGA_PAPER1.D34
SPIDER_UPDOWN_PIN_PWM: DRV_DC1.PWM, MEGA_PAPER1.D4
TEMP_PIN: CONN_TEMP1.2, MEGA_PAPER1.D37, MEGA_PAPER1.D46

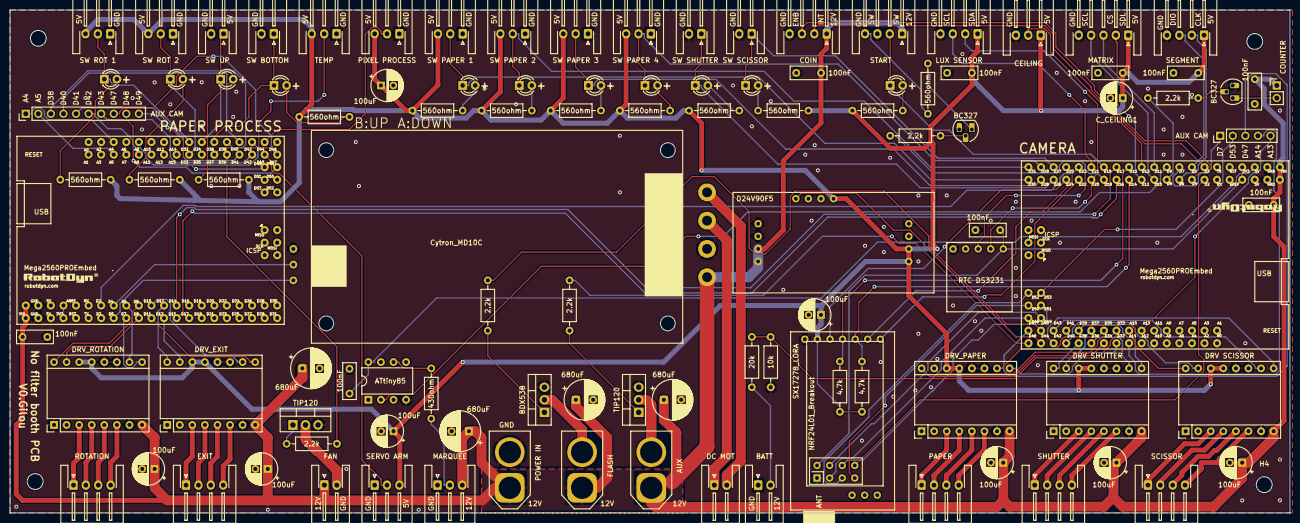
[picture p11: board nofilterbooth.kicad_pcb from above]

Board: 2 copper layers, 258.6 x 101.6 mm, 111 parts (0 on the bottom side), 135 nets.
