rataflo/photocabine/src_newpcb/camera/paper.cpp

#include "paper.h"

// Paper stepper
AccelStepper paper(1, PAPER_PIN_STP, PAPER_PIN_DIR);
// Opto endstops for paper.
Input<PAPER_SWITCH1_PIN> opto1(true);// Activate pullup
Input<PAPER_SWITCH2_PIN> opto2(true);
Input<PAPER_SWITCH3_PIN> opto3(true);
Input<PAPER_SWITCH4_PIN> opto4(true);
Output<PAPER_PIN_ENABLE> enablePaper;
Output<PAPER_M0> m0Paper;

void movePaperFirstShot() {
  debug("movePaperFirstShot", String("begin"));
  enablePaper.write(LOW);
  paper.setCurrentPosition(0);
  paper.setMaxSpeed(PAPER_SPEED);
  paper.setAcceleration(PAPER_ACCEL);
  
  boolean bOpto1 = opto1.read();
  int homing = 0;
  while (bOpto1) { 
    paper.moveTo(homing); 
    paper.run();
    homing--;
    delay(5);
    bOpto1 = opto1.read();
  }
  paper.setCurrentPosition(0);
  
  // marche arriére
  int delta = DELTA_FIRST_SHOT;
  paper.moveTo(delta); 
  paper.setMaxSpeed(PAPER_SPEED);
  paper.setAcceleration(PAPER_ACCEL);
  while(paper.currentPosition() != delta){
    paper.run();
  }
  enablePaper.write(HIGH);
}

void initPaper() {
  debug("initPaper", String("begin"));
  m0Paper.write(LOW);
  enablePaper.write(LOW);
  paper.setCurrentPosition(0);
  paper.setMaxSpeed(PAPER_SPEED);
  paper.setAcceleration(PAPER_ACCEL);
  
  int homing = 0;
  boolean bOpto1 = opto1.read();
  // case no paper detected, move a little bit then stop to allow to insert new roll of paper manually.
  paper.moveTo(100);
  while (!bOpto1 && paper.currentPosition() != 100) { 
    paper.run();
    bOpto1 = opto1.read();
  }

  // Manually mode if paper not detected.
  if(!bOpto1){
    enablePaper.write(HIGH);
    while (!bOpto1){
      bOpto1 = opto1.read();
    }
  }

  paper.setCurrentPosition(0);
  enablePaper.write(HIGH);
  
  movePaperFirstShot();
}

void movePaperNextShot(byte numShot) {
  debug("movePaperNextShot", String("begin"));
  showCountdown();
  enablePaper.write(LOW);
  paper.setCurrentPosition(0);
  paper.setMaxSpeed(PAPER_SPEED);
  paper.setAcceleration(PAPER_ACCEL);

  int delta = NB_STEP_PAPER_ONE_SHOT;
  paper.moveTo(delta); 
  while(paper.currentPosition() < delta){
    paper.run();
    refreshCountdown();
  }

  boolean bOpto = true;
  if(numShot == 2){
    bOpto = opto2.read();
  } else if(numShot == 3){
    bOpto = opto3.read();
  } else if(numShot == 4){
    bOpto = opto4.read();
  }

  // paper not at next stop, force it.
  if(!bOpto){
    paper.setCurrentPosition(0);
    paper.setMaxSpeed(PAPER_SPEED);
    paper.setAcceleration(PAPER_ACCEL);
  
    int homing = 0;
    while (!bOpto) { 
      paper.moveTo(homing); 
      paper.run();
      homing++;
      delay(5);
      if(numShot == 2){
        bOpto = opto2.read();
      } else if(numShot == 3){
        bOpto = opto3.read();
      } else if(numShot == 4){
        bOpto = opto4.read();
      }
    }
  }
  while(getCountDown() > 0){
    refreshCountdown();
  }
  //enablePaper.write(HIGH);
}

void movePaperOut() {
  debug("movePaperOut", String("begin"));
  enablePaper.write(LOW);
  paper.setCurrentPosition(0);
  paper.setMaxSpeed(PAPER_SPEED);
  paper.setAcceleration(PAPER_ACCEL);

  int delta = NB_STEP_PAPER_OUT;
  paper.moveTo(delta); 

  while(paper.currentPosition()< delta){
    paper.run();
  }
  enablePaper.write(HIGH);
}

boolean readSWPaper1(){
  return opto1.read();
}

boolean readSWPaper2(){
  return opto2.read();
}

boolean readSWPaper3(){
  return opto3.read();
}

boolean readSWPaper4(){
  return opto4.read();
}
