rataflo/photocabine/src_newpcb/paperProcess/tests.cpp

#include "tests.h"

void testMode(struct storage *params){
  Serial.println("testMode - begin");
  unsigned long lastMillis = 0;
  unsigned long currentMillis = 0;
  char testOrder = NO_ORDER;
  //Serial3.println(order);
  while (testOrder != EXIT_TEST){
    currentMillis = millis();
    
    if(Serial3.available() > 0){
      testOrder = Serial3.read();
      Serial.println(testOrder);
      Serial3Clear();
    }
    
    switch(testOrder){
      case EXIT_TEST:
        Serial3.print(RESPONSE_OK);
        Serial3.flush();
        testOrder = EXIT_TEST;
        break;
      case ORDER_GET_STATUS: // get status.
        Serial3.print(RESPONSE_STATUS_TEST);
        Serial3.flush();
        testOrder = NO_ORDER;
        break;
      case ORDER_SPIDER_READY: // get status.
        Serial3.print(RESPONSE_STATUS_TEST);
        Serial3.flush();
        testOrder = NO_ORDER;
        break;
      case ORDER_UPSPIDER: // Go spider to the top
        initSpiderUp();
        testOrder = NO_ORDER;
        break;
      case ORDER_DOWNSPIDER: // Go spider to the top
        initSpiderBottom();
        testOrder = NO_ORDER;
        break;
      case ORDER_ROTATESPIDER: // Rotate spider.
        rotateSpider(params);
        testOrder = NO_ORDER;
        break;
      case ORDER_OPENARM: // Open arm
        openArm(params);
        testOrder = NO_ORDER;
        break;
      case ORDER_CLOSEARM: // Close arm
        closeArm(params);
        testOrder = NO_ORDER;
        break;
      case ORDER_IDLEARM: // Put the arm on idle pos.
        setServoArmWaitPos();
        testOrder = NO_ORDER;
        break;
      case ORDER_DELIVERYRUN: // Run the delivery indefinitely.
        runDelivery(params);
        testOrder = NO_ORDER;
        break;
      case ORDER_LEDSTRIP: // flash led strip.
        lightFullStrip();
        testOrder = NO_ORDER;
        break;
    }
  }
  Serial.println("testMode - end");
}

void sendAnswer(boolean answer){
  char transco = answer ? ORDER_TRUE : ORDER_FALSE;
  Serial.println(answer);
  Serial3.print(transco);
  Serial3.flush();
}

void debug(String functionName, String varValue){
  #ifdef DEBUG_MODE
    Serial.println(functionName + ":" + varValue);
  #endif
}

void debug(String functionName, boolean varValue){
  #ifdef DEBUG_MODE
    Serial.println(functionName + ":" + (varValue ? "true": "false"));
  #endif
}

void debug(String functionName, byte varValue){
  #ifdef DEBUG_MODE
    Serial.println(functionName + ":" + varValue);
  #endif
}

void Serial3Clear(){
  while(Serial3.available() > 0) { 
    char t = Serial3.read(); 
  }
} 
