rataflo/photocabine/(commit log)

2018-02-27 feat: servo arm init
2018-03-10 dc motor, button start
2018-03-18 refactor: move spider code to second arduino.
2018-03-27 Add segment display and led matrix
2018-04-23 feat: i2c + debug
2018-05-14 fix after thsf & remove DiretIO library.
    [camera.ino, constants.h, shutter.h, test_servo_arm.ino, test_stepper_scissor.ino]
2019-01-24 Begin of complete refactor. Use Serial instead of I2C for communication between arduino.
2019-02-20 Radio interrupt for pause
2019-02-27 interrupt & more communication
2019-12-25 Only 1 servo to open & close arms
2019-12-26 Support for lux sensor TSL2591 from adafruit
2020-01-14 debug mode on camera
2020-01-14 Init EasyEda electronic schematic
    [1-Schematic_No filter booth pcb.json]
2020-01-15 open & close arm
2020-01-21 Init power & light section
2020-01-25 Update pcb schematic
    [1-PCB_PCB_2020-01-23 22_02_10.json, 1-Schematic_No filter booth pcb.json]
2020-01-26 update pcb schematics
    [1-Schematic_No filter booth pcb.json]
2020-02-02 update model & schematics
    [1-PCB_PCB_2020-01-23 22_02_10.json, 1-Schematic_No filter booth pcb.json]
2020-02-02 advices from Gilou on PCB
    [1-PCB_PCB_2020-01-23 22_02_10.json, 1-Schematic_No filter booth pcb.json]
2020-02-09 move to kicad
    [camera.sch, nofilterbooth.kicad_pcb, nofilterbooth.sch, paper.sch]
2020-02-10 kicad schematic & pcb v0.1
    [1-PCB_PCB_2020-01-23 22_02_10.json, 1-Schematic_No filter booth pcb.json, BOM_No_filter_booth_20200206081747.csv, BOM_No_filter_booth_20200206081747.ods, Schematic.schdoc, SchematicV2.schdoc, camera.sch, nofilterbooth.dsn]
2020-02-12 correction schematic gilou
    [camera.sch, nofilterbooth.kicad_pcb, nofilterbooth.sch, paper.sch]
2020-02-13 remove unecessary easyeda schematics
    [1-PCB_PCB_2020-01-23 22_02_10.json, 1-Schematic_No filter booth pcb.json]
2020-02-16 update, gilou dans la place
    [camera.sch, dc_motor_support_xd-3420.skp, nofilterbooth.dsn, nofilterbooth.kicad_pcb, nofilterbooth.sch, paper.sch, power_placed.kicad_pcb, route.kicad_pcb]
2020-02-17 pcb finalized
    [camera.sch, nofilterbooth.dsn, nofilterbooth.kicad_pcb, paper.sch]
2020-02-20 chemical recipes
    [chemical_recipes.ods, support_6000Z.skp]
2020-02-25 Update, code for the pcb version.
    [chemical_recipes.ods, nofilterbooth.kicad_pcb, paper.sch]
2020-04-20 Code for new pcb, new spider mechanism (3rd iteration), confinment day 36
2020-07-09 Update checmical recipes
    [chemical_recipes.ods]
2020-09-16 update camera V2
2020-09-23 update model for laser cut
2020-11-24 Files for lasercut parts
    [lasercut1_bis.dxf, lasercut2.dxf, lasercut2_bis.dxf]
2021-01-10 Camera system V2
2021-03-23 New paper feed.
    [paper_support_spider.skp]
2021-03-27 New try for cutting system
    [paper_support_spider.skp]
2021-04-13 new paper holder and cutter
    [paper_support_spider.skp]
